VughtseProgrammeerclub/printer-project/vpc_printerproject-schema_2024-10-28_0805.pdf

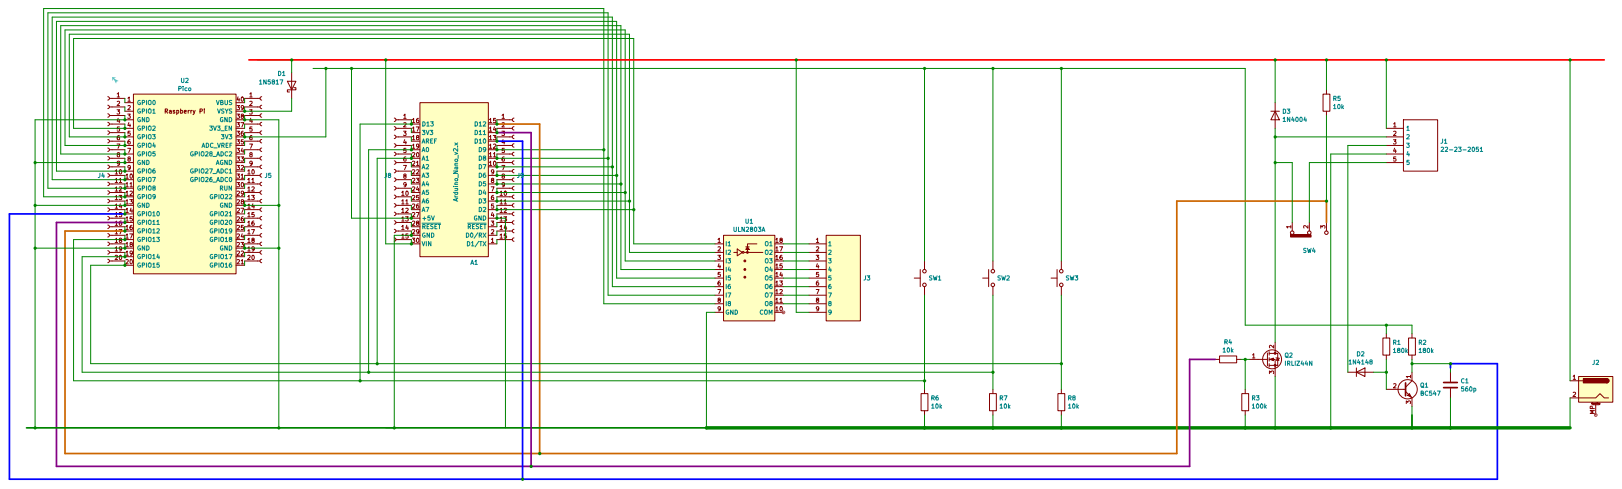
[picture p8: page 1]
