VughtseProgrammeerclub/printer-project/(list of files, drawings)

Other design files:
vpc - printerproject 2024-08-24-2040.spl7
