VughtseProgrammeerclub/printer-project/vpc_printerproject-onderdelen_2024-10-28_0805.pdf

Reference Value
A1 | Arduino_Nano_v2.x
C1 | 560p
D1 | 1N5817
D2 | 1N4148
D3 | 1N4004
J1 | 22-23-2051
J2 | Barrel_Jack_MountingPin
J3 | DS1020-09RT1D
J4 | Conn_01x20_Socket
J5 | Conn_01x20_Socket
J8 | Conn_01x15_Pin
J9 | Conn_01x15_Pin
Q1 | BC547
Q2 | IRLIZ44N
R1 | 180k | Bruin-Grijs-Geel
R2 | 180k | Bruin-Grijs-Geel
R3 | 100k | Bruin-Zwart-Geel
R4 | 10k | Bruin-Zwart-Oranje
R5 | 10k | Bruin-Zwart-Oranje
R6 | 10k | Bruin-Zwart-Oranje
R7 | 10k | Bruin-Zwart-Oranje
R8 | 10k | Bruin-Zwart-Oranje
SW1 | SW_Push
SW2 | SW_Push
SW3 | SW_Push
SW4 | SW_Slide_DPDT
U1 | ULN2803A
U2 | Pico
