VughtseProgrammeerclub/printer-project/printerprojectConnector.png

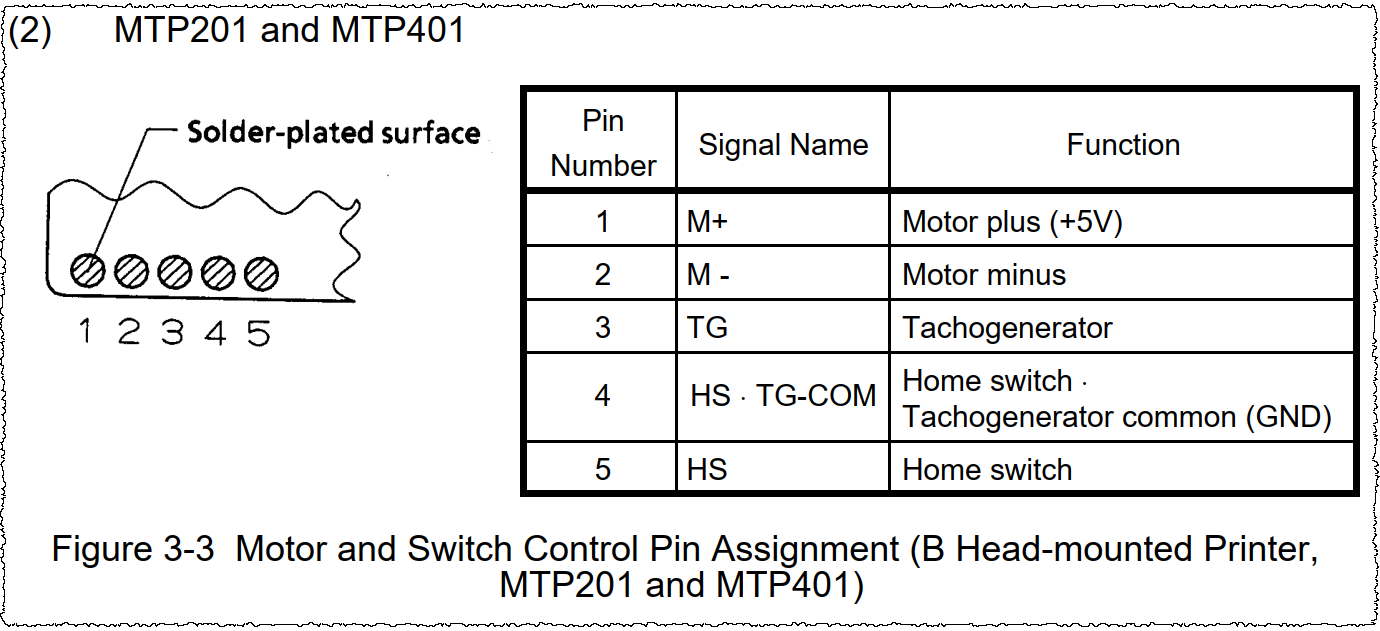
printerprojectConnector.png
