VughtseProgrammeerclub/printer-project/(commit log)

2024-08-21 Update README.md
    Info over driver-ic LB1257 toegevoegd
2024-09-22 Create Aantekeningen printplaat
2024-10-30 Add files via upload
    Om je 3 knoppen op de print te testen met Raspberry Pi pico. Knoppen 1 seconden vasthouden.
    Linkse knop is LED aan
    Middelste knop is LED knippert
    Rechtse knop is LED uit
2025-01-21 Voeg de letter Q toe
2025-02-04 Add files via upload
    Spelletje STEEN/PAPIER/SCHAAR voor het printerproject. Een van de 3 knoppen op de printplaat indrukken om het spel te spelen. De printer drukt jouw keuze en het resultaat af. Kijk maar of jij kunt winnen van de printer!
